Silverlined/StuCo-ToyTronix-Soldering-Kit/README.md

# ToyTronix Student Company - Soldering Kit

ToyTronix - a soldering kit for young children. The idea was inspired by [Shawn Hymmel's 555 timer badge](https://twitter.com/oshpark/status/1000262755927064576). I worked through the whole process of design to production.

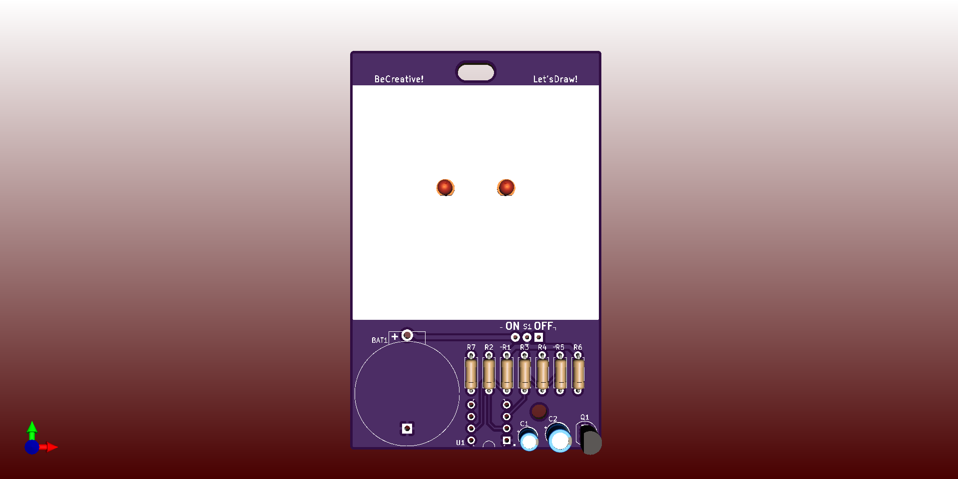
[picture p1: misc/rendering.png]


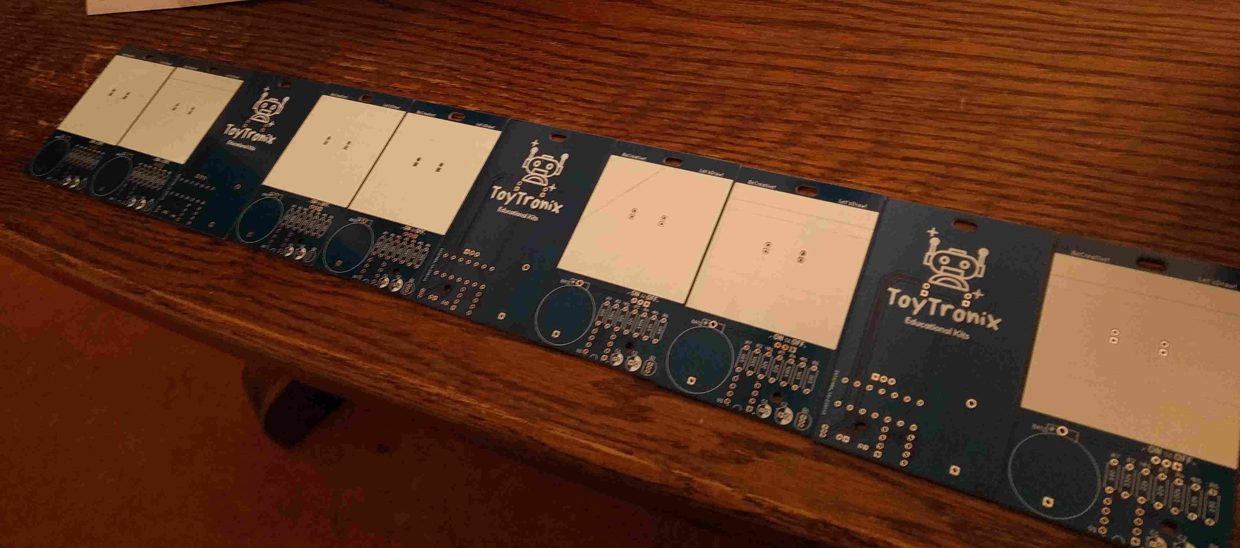
[picture p2: misc/batch.jpg]


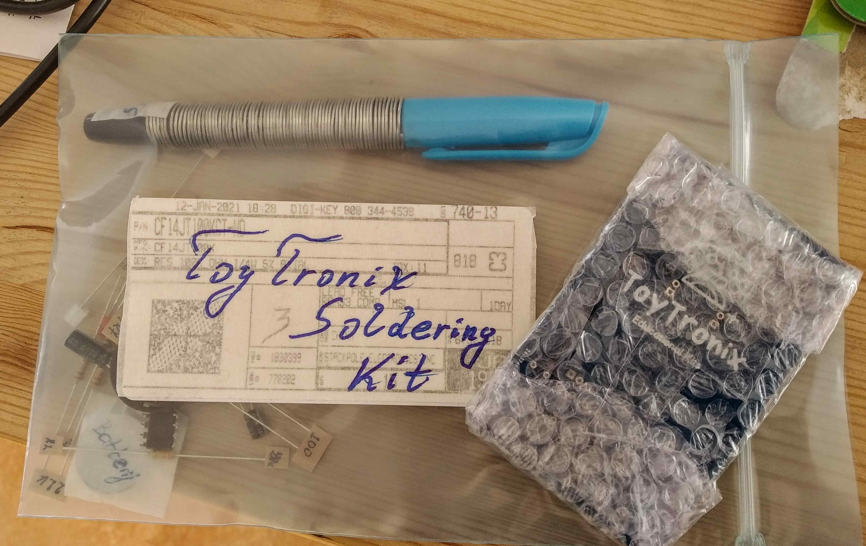
[picture p3: misc/product.jpg]


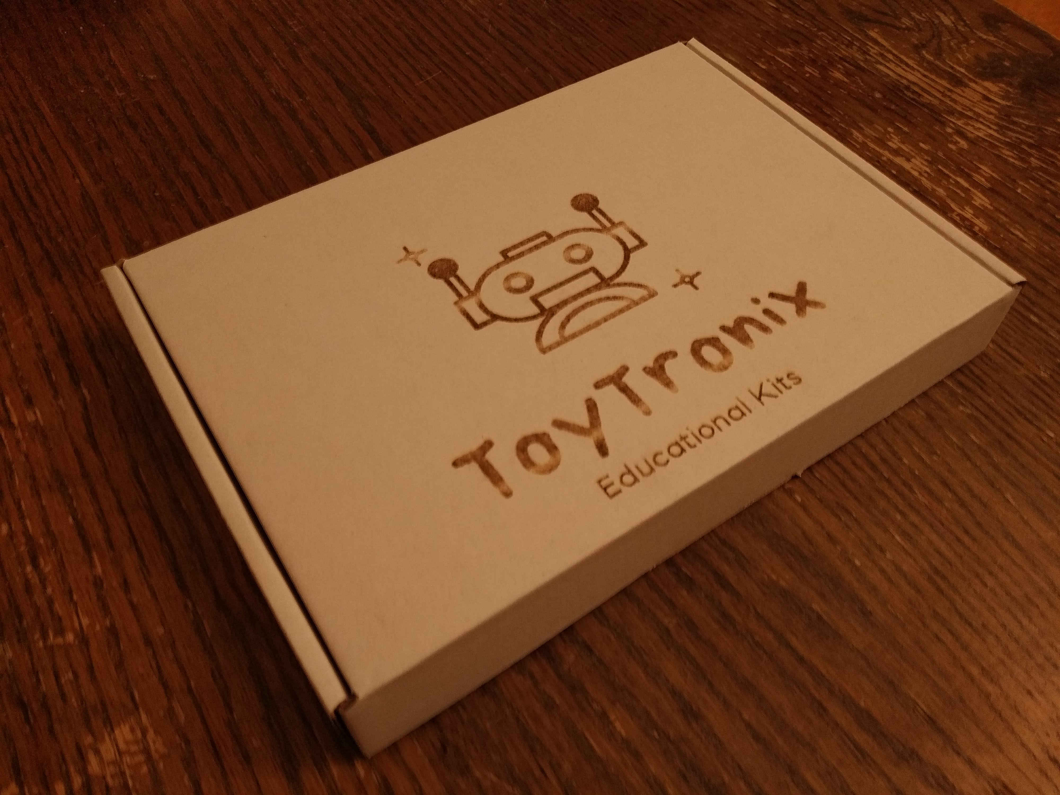
[picture p4: misc/enclosure.jpg]
