Silverlined/StuCo-ToyTronix-Soldering-Kit/Video-Pitch.docx

“An investment in knowledge always pays the best interest.”, you might recognize this saying by Benjamin Franklin.

My team and I firmly believe this to be true… My name is Dimitriy and this is ToyTronix - Educational Kits.

As we know, the current pandemic has affected every single sector of our economy and especially the educational sector, which has been highly disrupted. In this regard, my team and I acknowledged the need for better remote learning experience and decided to create a low cost educational kit for young children.

* *

Essentially, we want to provide children with a unique soldering kit that will introduce them to the world of electronics and teach them practical skills.

The combination of carefully chosen components and a specially designed manual, which not only gives instructions of how, but also explains the why, will allow children to build their own personalised artistic toy.

**

We intend to begin production with a batch of 20 units and a price of €14.99. This will generate a revenue of €300 that will be used for the further development of the company.

I encourage you to give chance to ToyTronix - Educational Kits, because with ToyTronix, kids are not only going to have fun building their own toys, but also learn and discover what they really enjoy doing.
