Silverlined/StuCo-ToyTronix-Soldering-Kit/assembly/BOM.pdf

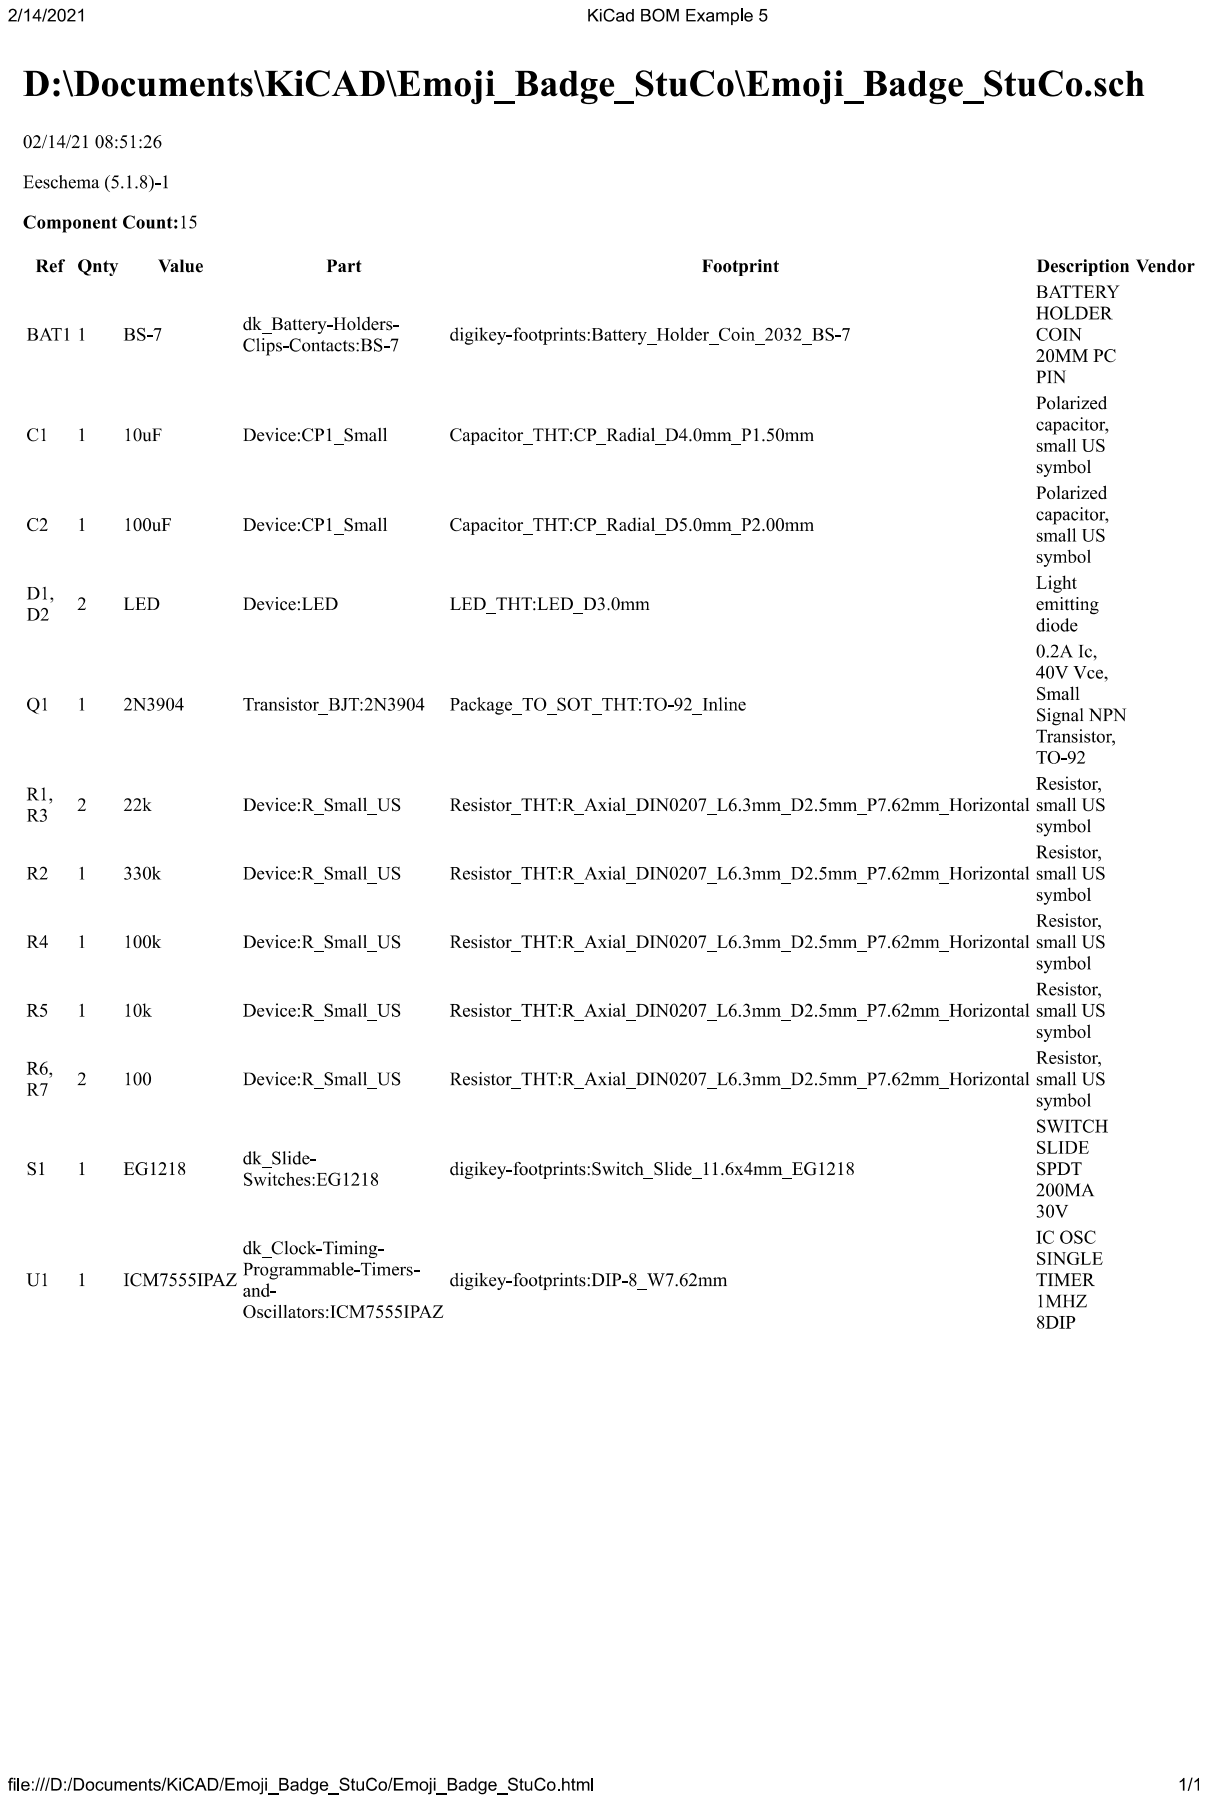
[picture p5: page 1]
