Silverlined/StuCo-ToyTronix-Soldering-Kit/KiCAD/Emoji_Badge_StuCo.kicad_pcb

## KiCad design KiCAD/Emoji_Badge_StuCo.kicad_pcb (2021-03-31)

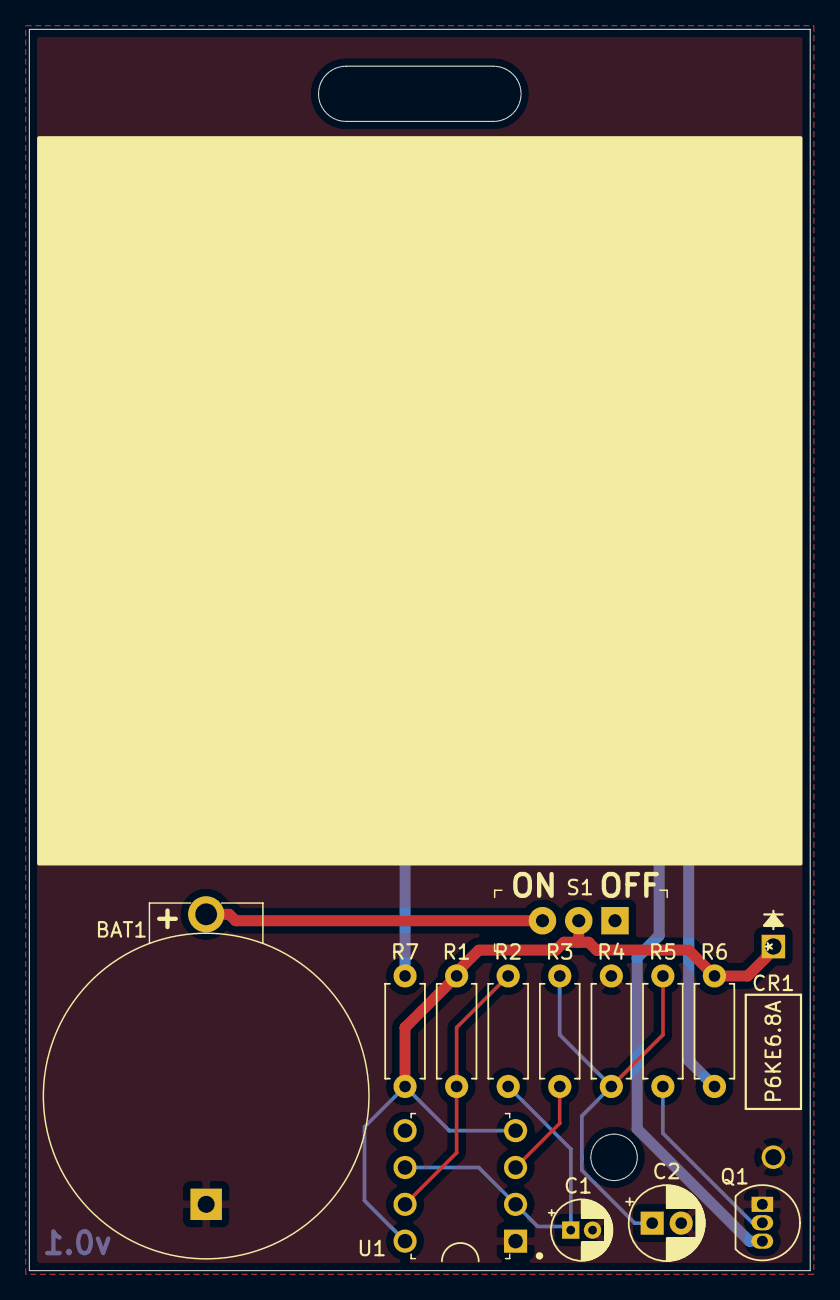
[picture p6: board Emoji_Badge_StuCo.kicad_pcb from above]

Board: 2 copper layers, 53.8 x 85.6 mm, 16 parts (0 on the bottom side), 11 nets.

Parts:
BAT1: BS-7; Battery_Holder_Coin_2032_BS-7
C1: 10uF; CP_Radial_D4.0mm_P1.50mm
C2: 100uF; CP_Radial_D5.0mm_P2.00mm
CR1: P6KE6.8A
D1, D2: LED; LED_D3.0mm
Q1: 2N3904; TO-92_Inline
R1, R3: 22k; R_Axial_DIN0207_L6.3mm_D2.5mm_P7.62mm_Horizontal
R2: 330k; R_Axial_DIN0207_L6.3mm_D2.5mm_P7.62mm_Horizontal
R4: 100k; R_Axial_DIN0207_L6.3mm_D2.5mm_P7.62mm_Horizontal
R5: 10k; R_Axial_DIN0207_L6.3mm_D2.5mm_P7.62mm_Horizontal
R6, R7: 100; R_Axial_DIN0207_L6.3mm_D2.5mm_P7.62mm_Horizontal
S1: EG1218; Switch_Slide_11.6x4mm_EG1218
U1: ICM7555IPAZ; DIP-8_W7.62mm

Connections:
DISCH: R1.2, R2.1, U1.7
GND: BAT1.Neg, C1.2, C2.2, CR1.2, Q1.1, R4.1, U1.1
unnamed: BAT1.Pos, S1.3
unnamed: C1.1, R2.2, U1.2, U1.6
unnamed: C2.1, R3.1, R4.2, R5.1
unnamed: D1.1, D2.1, Q1.3
unnamed: D1.2, R6.2
unnamed: D2.2, R7.2
unnamed: Q1.2, R5.2
unnamed: R3.2, U1.3
VCC: CR1.1, R1.1, R6.1, R7.1, S1.2, U1.4, U1.8
